MuddSub/crush-main-board/crush-main-board.kicad_pcb

## KiCad design crush-main-board.kicad_pcb (2025-02-09)

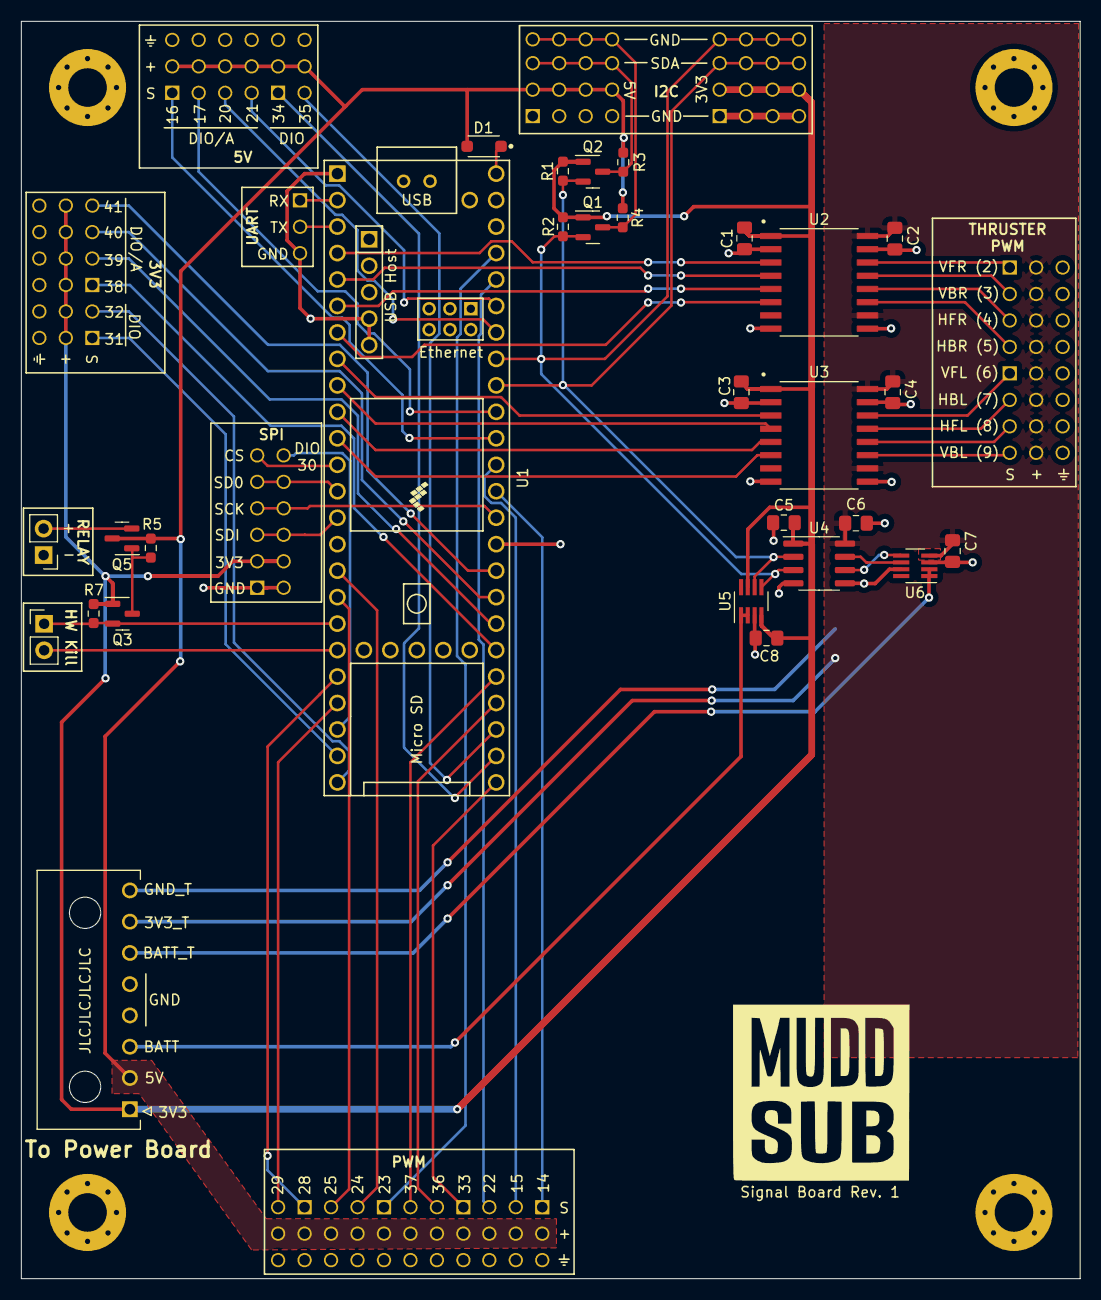
[picture p1: board crush-main-board.kicad_pcb from above]

Board: 2 copper layers, 101.6 x 120.6 mm, 46 parts (0 on the bottom side), 64 nets.

Parts:
C1, C2, C3, C4, C5, C6, C7, C8: 0u1; C_0805_2012Metric_Pad1.18x1.45mm_HandSolder
D1: SM5817PL-TP; SODFL3718X108N
H1, H2, H3, H4: MountingHole_Pad; MountingHole_3.7mm_Pad_Via
J1, J2: 4x4_Header
J3: 6x2_Header
J4: 3x1_Header
J5, J6, J12: 3x2 Header; 3x2_Header
J7, J8: 3x4 Header; 3x4_Header
J9, J10, J11: 3x3 Header; 3x3_Header
J13, J14: 3x4_Header
J15: 2157601008; MOLEX_2157601008
J16, J17: Conn_01x02; PinHeader_1x02_P2.54mm_Vertical
Q1, Q2, Q3: BSN20; SOT-23
Q5: DMG2301L; SOT-23
R1, R2, R3, R4, R5, R7: 2k4; R_0603_1608Metric_Pad0.98x0.95mm_HandSolder
U1: Teensy4.1; Teensy41
U2, U3: ISO7740DW; SOIC127P1030X265-16N
U4: ISO1640BDR; SOIC-8_3.9x4.9mm_P1.27mm
U5, U6: INA232B; SOT-23-8_Handsoldering

Connections:
+3V3: C1.2, C3.2, C5.2, C8.2, J1.02, J1.06, J1.10, J1.14, J3.02, J3.08, J5.02, J5.05, J7.02, J7.05, J7.08, J7.11, J15.1, Q1.1 (G), Q2.1 (G), Q3.1 (G), R1.1, R2.1, R7.1, U2.1 (VCC1), U3.1 (VCC1), U4.1 (VCC1), U5.4 (VS), U5.7 (A0)
+3V3_T: C2.2, C4.2, C6.2, C7.2, J13.02, J13.05, J13.08, J13.11, J14.02, J14.05, J14.08, J14.11, J15.7, U2.10 (EN2), U2.16 (VCC2), U3.10 (EN2), U3.16 (VCC2), U4.8 (VCC2), U6.4 (VS)
+5V: D1.2 (A), J2.02, J2.06, J2.10, J2.14, J6.02, J6.05, J8.02, J8.05, J8.08, J8.11, J9.02, J9.05, J9.08, J10.02, J10.05, J10.08, J11.02, J11.05, J11.08, J12.02, J12.05, J15.2, Q5.3 (D), R3.1, R4.1, R5.1
/+RELAY: J17.2, Q5.2 (S)
/SCL_T: U4.6 (SCL2), U6.5 (SCL)
/SDA_T: U4.7 (SDA2), U6.6 (SDA)
A/DIO16: J8.01, U1.38 (16_A2_RX4_SCL1)
A/DIO17: J8.04, U1.39 (17_A3_TX4_SDA1)
A/DIO20: J8.07, U1.42 (20_A6_TX5_LRCLK1)
A/DIO21: J8.10, U1.43 (21_A7_RX5_BCLK1)
A/DIO26: J16.1, Q3.2 (S), R7.2, U1.18 (26_A12_MOSI1)
A/DIO38: J7.01, U1.30 (38_CS1_IN1)
A/DIO39: J7.04, U1.31 (39_MISO1_OUT1A)
A/DIO40: J7.07, U1.32 (40_A16)
A/DIO41: J7.10, U1.33 (41_A17)
BATT: J15.3, U5.1 (Vin+), U5.2 (Vin-)
BATT_T: J15.6, U6.1 (Vin+), U6.2 (Vin-)
DIO30: J3.12, U1.22 (30_CRX3)
DIO31: J5.01, U1.23 (31_CTX3)
DIO32: J5.04, U1.24 (32_OUT1B)
DIO34: J6.01, U1.26 (34_RX8)
DIO35: J6.04, U1.27 (35_TX8)
GND: C1.1, C3.1, C5.1, C8.1, H1.1, H2.1, H3.1, H4.1, J1.01, J1.05, J1.09, J1.13, J2.01, J2.05, J2.09, J2.13, J3.01, J3.07, J4.03, J5.03, J5.06, J6.03, J6.06, J7.03, J7.06, J7.09, J7.12, J8.03, J8.06, J8.09, J8.12, J9.03, J9.06, J9.09, J10.03, J10.06, J10.09, J11.03, J11.06, J11.09, J12.03, J12.06, J15.4, J15.5, J17.1, U1.1 (GND), U1.34 (GND), U1.47 (GND), U1.58 (GND), U1.59 (GND), U2.2 (GND1), U2.8 (GND1), U3.2 (GND1), U3.8 (GND1), U4.4 (GND1), U5.3 (GND)
GND_T: C2.1, C4.1, C6.1, C7.1, J13.03, J13.06, J13.09, J13.12, J14.03, J14.06, J14.09, J14.12, J15.8, U2.9 (GND2), U2.15 (GND2), U3.9 (GND2), U3.15 (GND2), U4.5 (GND2), U6.3 (GND), U6.7 (A0)
Kill: J16.2, U1.19 (27_A13_SCK1)
unnamed: D1.1 (K), U1.48 (VIN)
unnamed: Q3.3 (D), Q5.1 (G), R5.2
PWM2: U1.4 (2_OUT2), U2.3 (INA)
PWM2_T: J13.01, U2.14 (OUTA)
PWM3: U1.5 (3_LRCLK2), U2.4 (INB)
PWM3_T: J13.04, U2.13 (OUTB)
PWM4: U1.6 (4_BCLK2), U2.5 (INC)
PWM4_T: J13.07, U2.12 (OUTC)
PWM5: U1.7 (5_IN2), U2.6 (IND)
PWM5_T: J13.10, U2.11 (OUTD)
PWM6: U1.8 (6_OUT1D), U3.3 (INA)
PWM6_T: J14.01, U3.14 (OUTA)
PWM7: U1.9 (7_RX2_OUT1A), U3.4 (INB)
PWM7_T: J14.04, U3.13 (OUTB)
PWM8: U1.10 (8_TX2_IN1), U3.5 (INC)
PWM8_T: J14.07, U3.12 (OUTC)
PWM9: U1.11 (9_OUT1C), U3.6 (IND)
PWM9_T: J14.10, U3.11 (OUTD)
PWM14: J9.01, U1.36 (14_A0_TX3_SPDIF_OUT)
PWM15: J9.04, U1.37 (15_A1_RX3_SPDIF_IN)
PWM22: J9.07, U1.44 (22_A8_CTX1)
PWM23: J10.01, U1.45 (23_A9_CRX1_MCLK1)
PWM24: J10.04, U1.16 (24_A10_TX6_SCL2)
PWM25: J10.07, U1.17 (25_A11_RX6_SDA2)
PWM28: J12.01, U1.20 (28_RX7)
PWM29: J12.04, U1.21 (29_TX7)
PWM33: J11.01, U1.25 (33_MCLK2)
PWM36: J11.04, U1.28 (36_CS)
PWM37: J11.07, U1.29 (37_CS)
SCL_3V3: J1.04, J1.08, J1.12, J1.16, Q1.2 (S), R2.2, U1.41 (19_A5_SCL), U4.3 (SCL1), U5.5 (SCL)
SCL_5V: J2.04, J2.08, J2.12, J2.16, Q1.3 (D), R4.2
SDA_3V3: J1.03, J1.07, J1.11, J1.15, Q2.2 (S), R1.2, U1.40 (18_A4_SDA), U4.2 (SDA1), U5.6 (SDA)
SDA_5V: J2.03, J2.07, J2.11, J2.15, Q2.3 (D), R3.2
SPI_CS: J3.06, U1.12 (10_CS_MQSR)
SPI_SCK: J3.04, J3.10, U1.35 (13_SCK_LED)
SPI_SDI: J3.03, J3.09, U1.14 (12_MISO_MQSL)
SPI_SDO: J3.05, J3.11, U1.13 (11_MOSI_CTX1)
UART_RX: J4.01, U1.2 (0_RX1_CRX2_CS1)
UART_TX: J4.02, U1.3 (1_TX1_CTX2_MISO1)
