MuddSub/crush-main-board/(commit log)

2023-02-27 baby change to test committing
    [crush-pcb.kicad_sch]
2023-03-12 Added Digital Isolators
    [crush-pcb.kicad_pcb, i2c_level_shifter.kicad_sch]
2023-03-26 Add labels for teensy ports
    [crush-pcb.kicad_sch]
2023-03-26 Update custom library and add PWM headers
    [crush-pcb.kicad_sch]
2023-03-27 Library Update
    Add the footprint library named "Crush_Mainboard_Footprints.pretty" in the library folder
    [crush-pcb.kicad_sch]
2023-03-27 Header Arrangement
    Add headers for the remaining pins and attach the custom footprints
    [crush-pcb.kicad_sch]
2023-03-31 Cleaned up the repo and added Teensy 4.1 to the Crush project library
    [crush-main-board.kicad_pcb, crush-main-board.kicad_sch]
2023-04-01 Deleted some unnecessary files that were renamed
    [crush-main-board.kicad_pcb, crush-main-board.kicad_sch, crush-pcb.kicad_pcb, crush-pcb.kicad_sch, i2c_level_shifter.kicad_sch]
2023-04-02 Update library with default footprints
2023-04-03 Add SPI, UART, ESC Headers; Fixed library stuff
    [crush-main-board.kicad_pcb, crush-main-board.kicad_sch]
2023-04-03 Fixed .gitignore and removed backup folders from repo
    [crush-main-board.kicad_sch]
2023-04-03 Cleaned up the schematic layout & separated the footprints into corresponding groups
    [crush-main-board.kicad_pcb, crush-main-board.kicad_sch]
2023-04-03 Clean up some minor details in the symbol and footprint library
2023-04-09 Fixed SPI header and updated footprint accordingly
    [crush-main-board.kicad_pcb, crush-main-board.kicad_sch]
2023-04-10 Removed USB connector (deemed unnecessary) as well as added infrastructure for a battery monitoring circuit
    [battery_monitor.kicad_sch]
2023-04-10 Added thruster battery monitoring circuit
    There is no footprint assigned for an I2C isolator and resistors yet
    [battery_monitor.kicad_sch, crush-main-board.kicad_pcb, crush-main-board.kicad_sch]
2023-04-10 fixed some minor error
    [battery_monitor.kicad_sch]
2023-04-10 added electrical side battery monitor in case we don't use Teensy's ADC
    [battery_monitor.kicad_sch, crush-main-board.kicad_sch]
2023-04-17 Added diode and header for remaining pins, fixed signal battery monitor
    [battery_monitor.kicad_sch, crush-main-board.kicad_pcb, crush-main-board.kicad_sch]
2023-04-17 Changed resistor and capacitor footprints to 0603
    [battery_monitor.kicad_sch, crush-main-board.kicad_sch, i2c_level_shifter.kicad_sch]
2023-04-23 Added library for MOLEX inter-board connector
2023-04-23 Added connection to the power board; and the remaining footprints
    [battery_monitor.kicad_sch, crush-main-board.kicad_pcb, crush-main-board.kicad_sch]
2023-04-24 Fixed an error of the "3V3_T" and "GND_T" and added some conditions for the PCB design
    The power nets for the thruster side require their own custom symbols unless they will refer to the same ones that are linked to the normal power nets
    [crush-main-board.kicad_pcb, crush-main-board.kicad_sch]
2023-04-25 Fixed some minor errors and arranged the components into two ground sides
    [crush-main-board.kicad_pcb, crush-main-board.kicad_sch]
2023-04-26 arranged all components to be ready for routing
    [crush-main-board.kicad_pcb]
2023-04-27 re-aligned the elements based on their grounds
    [crush-main-board.kicad_pcb, crush-main-board.kicad_sch]
2023-09-30 update i2c level shifter
    * Change resistors from 4.7k to 2.4k to improve signal quality
    * Connect SCL MOSFET gate to 3.3V rather than 5V
    [i2c_level_shifter.kicad_sch]
2023-11-04 Add battery monitoring circuit using INA233
    [battery_monitor.kicad_sch]
2023-11-04 minor visual change
    [battery_monitor.kicad_sch]
2023-11-04 Add shunt capacitor for INA233
    [battery_monitor.kicad_sch]
2023-11-04 Sketch out a possible circuit for the killswitch
    [crush-main-board.kicad_sch, relay_killswitch.kicad_sch]
2023-11-11 Switch to INA232
    [battery_monitor.kicad_sch, crush-main-board.kicad_sch, relay_killswitch.kicad_sch]
2023-11-18 Fix killswitch circuit
    [relay_killswitch.kicad_sch]
2023-11-18 Fix overlapping wires
    [relay_killswitch.kicad_sch]
2023-11-18 Add levelshifter textbox label
    [relay_killswitch.kicad_sch]
2023-12-02 Changed driving of relay to account for relay loading
    [relay_killswitch.kicad_sch]
2024-02-17 Updated reference for current monitoring chip
    [battery_monitor.kicad_sch]
2024-02-18 Wire up the relay killswitch with JSTs
    In the schematic
    [crush-main-board.kicad_sch]
2024-02-25 Start laying out main board
    [battery_monitor.kicad_sch, crush-main-board.kicad_pcb, crush-main-board.kicad_sch, relay_killswitch.kicad_sch]
2024-03-23 Add monitor for signal battery
    [battery_monitor.kicad_sch, crush-main-board.kicad_sch]
2024-03-23 Add changes to pcb
    [crush-main-board.kicad_pcb]
2024-04-06 fixed janky wire in killswitch subcircuit
    [relay_killswitch.kicad_sch]
2024-04-06 Fixed import issues from sch to pcb
    [crush-main-board.kicad_pcb, crush-main-board.kicad_sch]
2024-04-06 basic routing
    [crush-main-board.kicad_pcb, crush-main-board.kicad_sch]
2024-04-08 place mounting holes
    [crush-main-board.kicad_pcb, crush-main-board.kicad_sch]
2024-04-08 force solid mounting pad connections
    [crush-main-board.kicad_pcb]
2024-04-13 precise component layout
    [crush-main-board.kicad_pcb]
2024-04-13 placement updates
    [crush-main-board.kicad_pcb]
2024-04-13 fix thruster headers
    [crush-main-board.kicad_sch]
2024-04-13 schematic net fixes
    [crush-main-board.kicad_sch]
2024-04-13 more schematic fixes
    [crush-main-board.kicad_sch]
2024-04-13 fix unconnected components
    [crush-main-board.kicad_pcb]
2024-04-13 move trace
    [crush-main-board.kicad_pcb]
2024-04-20 Updated main board for better bypass caps & routing review
    [crush-main-board.kicad_pcb, crush-main-board.kicad_sch, relay_killswitch.kicad_sch]
2024-05-04 cleanup traces
    [crush-main-board.kicad_pcb]
2024-05-04 add JLC order number location
    [crush-main-board.kicad_pcb]
2024-09-28 add additional labeling to io ports
    [crush-main-board.kicad_pcb]
2024-09-28 use + instead of V for vcc
    [crush-main-board.kicad_pcb]
2024-09-28 update i2c pin order
    [crush-main-board.kicad_pcb, crush-main-board.kicad_sch]
2024-11-18 use 0805 footprints for decoupling capacitors
    [crush-main-board.kicad_pcb, crush-main-board.kicad_sch]
2025-02-09 move c7 cap
    [crush-main-board.kicad_pcb]
